rauulzamoora/Juanito-Sumo/README.md

# Juanito-Sumo
This repository is created as a supplement to the Construction and Operation Manual of the Sumo Bot Juanito, which is included in this repository.
