rauulzamoora/Juanito-Sumo/STL's/Porta Placa.stl

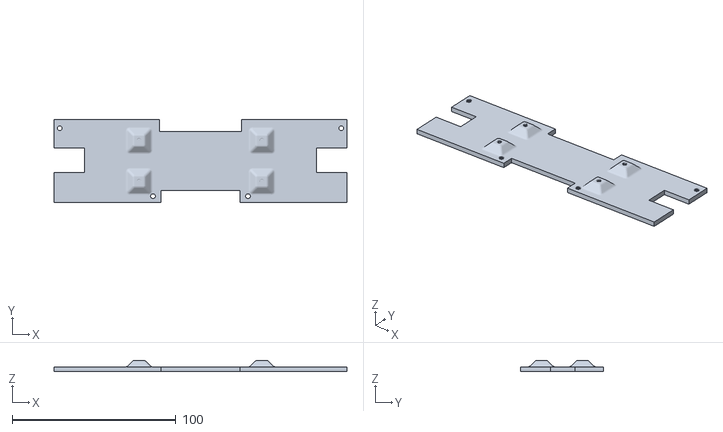
[picture p1: CAD file, 2024-10-24]
STL's/Porta Placa.stl
179.0 x 51.0 x 7.00
