rauulzamoora/Juanito-Sumo/STL's/Cubierta para boton.stl

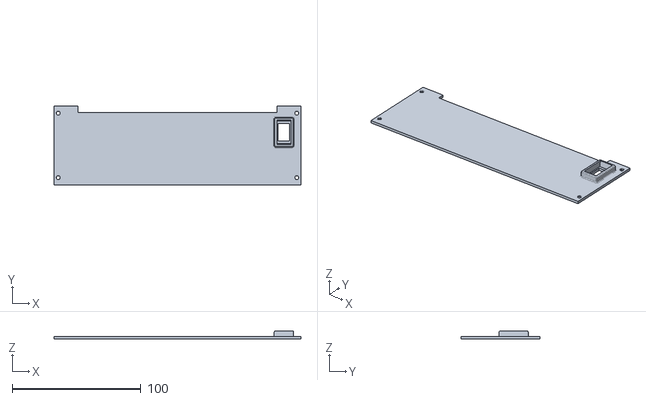
[picture p2: CAD file, 2024-10-24]
STL's/Cubierta para boton.stl
191.5 x 61.6 x 6.50
