rauulzamoora/Juanito-Sumo/(commit log)

2024-10-23 Add files via upload
    Library of the XMotion V3 board to use it in Arduino IDE
2024-10-24 Add files via upload
    Código Arduino
2024-10-24 Add files via upload
    STL files
    [Cubierta para boton.stl, Porta Placa.stl]
